Gherkin/Coaster/README.md

## A polar plotter for drawing on paper coasters
