Gherkin/Coaster/PCB/coaster.kicad_pcb

## KiCad design PCB/coaster.kicad_pcb (2022-04-20)

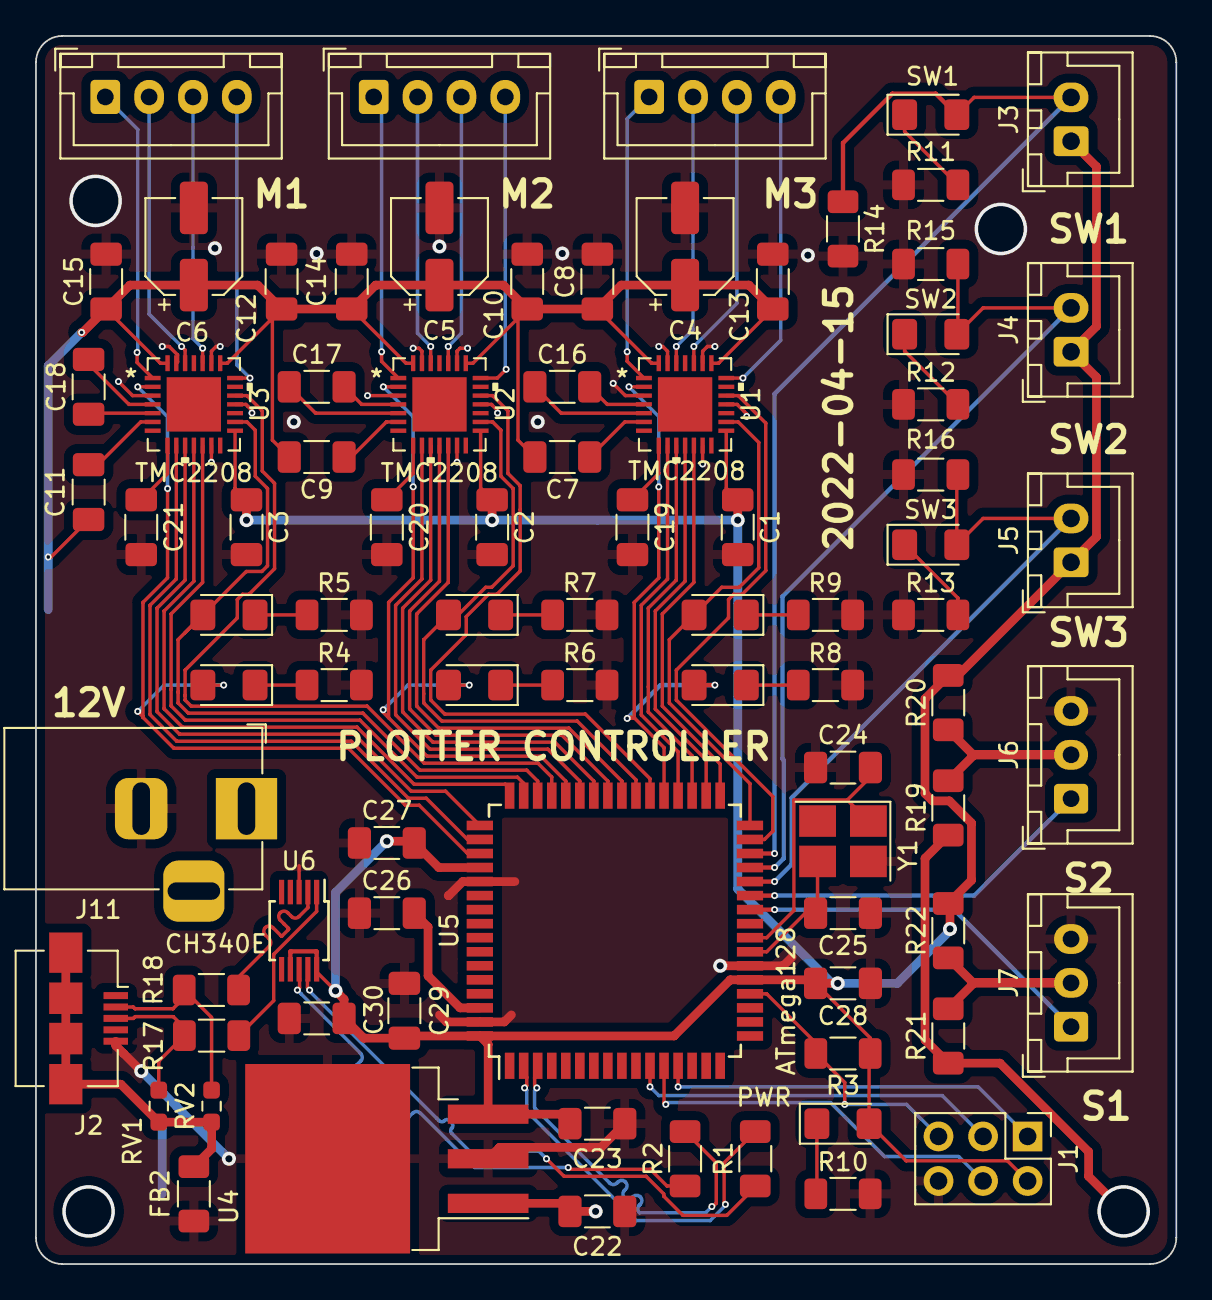
[picture p1: board coaster.kicad_pcb from above]

Board: 2 copper layers, 65.0 x 70.0 mm, 83 parts (0 on the bottom side), 81 nets.

Parts:
C1, C2, C3, C7, C8, C9, C10, C11, C12, C13, C14, C15, C23, C26, C27, C28, C29, C30: 100n; C_1206_3216Metric_Pad1.33x1.80mm_HandSolder
C4, C5, C6: 100u; CP_Elec_5x5.4
C16, C17, C18: 22n; C_1206_3216Metric_Pad1.33x1.80mm_HandSolder
C19, C20, C21: 2.2u; C_1206_3216Metric_Pad1.33x1.80mm_HandSolder
C22: 0.33u; C_1206_3216Metric_Pad1.33x1.80mm_HandSolder
C24, C25: 20p; C_1206_3216Metric_Pad1.33x1.80mm_HandSolder
D1: M1EN; LED_1206_3216Metric_Pad1.42x1.75mm_HandSolder
D2: M1STEP; LED_1206_3216Metric_Pad1.42x1.75mm_HandSolder
D3: M2EN; LED_1206_3216Metric_Pad1.42x1.75mm_HandSolder
D4: M2STEP; LED_1206_3216Metric_Pad1.42x1.75mm_HandSolder
D5: M3EN; LED_1206_3216Metric_Pad1.42x1.75mm_HandSolder
D6: M3STEP; LED_1206_3216Metric_Pad1.42x1.75mm_HandSolder
D7: PWR; LED_1206_3216Metric_Pad1.42x1.75mm_HandSolder
D8: SW1; LED_1206_3216Metric_Pad1.42x1.75mm_HandSolder
D9: SW2; LED_1206_3216Metric_Pad1.42x1.75mm_HandSolder
D10: SW3; LED_1206_3216Metric_Pad1.42x1.75mm_HandSolder
FB2: FerriteBead; R_1206_3216Metric_Pad1.30x1.75mm_HandSolder
J1: AVR-ISP-6; PinHeader_2x03_P2.54mm_Vertical
J2: USB_B_Micro; USB_Micro-B_Amphenol_10104110_Horizontal
J3, J4, J5: Conn_01x02; JST_XH_B2B-XH-A_1x02_P2.50mm_Vertical
J6, J7: Conn_01x03; JST_XH_B3B-XH-A_1x03_P2.50mm_Vertical
J8, J9, J10: Conn_01x04; JST_XH_B4B-XH-A_1x04_P2.50mm_Vertical
J11: Barrel_Jack; BarrelJack_Horizontal
R1, R2: 1k; R_1206_3216Metric_Pad1.30x1.75mm_HandSolder
R3, R14, R15, R16: 10k; R_1206_3216Metric_Pad1.30x1.75mm_HandSolder
R4, R6, R8, R10: 100; R_1206_3216Metric_Pad1.30x1.75mm_HandSolder
R5, R7, R9, R11, R12, R13: 120; R_1206_3216Metric_Pad1.30x1.75mm_HandSolder
R17, R18: 22; R_1206_3216Metric_Pad1.30x1.75mm_HandSolder
R19, R20, R21, R22: 0; R_1206_3216Metric_Pad1.30x1.75mm_HandSolder
RV1, RV2: CG0603MLC-05E; R_0603_1608Metric_Pad0.98x0.95mm_HandSolder
U1, U2, U3: TMC2208; TMC2208-LA
U4: uA7805; TO-263-3_TabPin2
U5: ATmega128; TQFP-64_14x14mm_P0.8mm
U6: CH340E; MSOP-10_3x3mm_P0.5mm
Y1: 16MHz 12pF 60 Ohm +/- 10 ppm; Crystal_SMD_3225-4Pin_3.2x2.5mm_HandSoldering

Connections:
/5V: C1.1, C2.1, C3.1, C23.1, C27.2, C28.2, C29.1, C30.1, D7.2 (A), J1.2 (VCC), J3.1, J4.1, J5.1, R3.1, R20.2, R22.2, U1.15 (VCC_IO), U2.15 (VCC_IO), U3.15 (VCC_IO), U4.3 (OUT), U5.21 (VCC), U5.52 (VCC), U5.64 (AVCC), U6.7 (VCC), U6.10 (V3)
/9V: C4.1, C5.1, C6.1, C7.2, C8.1, C9.2, C10.1, C11.2, C12.1, C13.1, C14.1, C15.1, C22.1, J11.1, R19.1, R21.1, U1.22 (VS), U1.28 (VS), U2.22 (VS), U2.28 (VS), U3.22 (VS), U3.28 (VS), U4.1 (IN)
/AUART_N: R2.2, U5.3 (PE1)
/AUART_P: R1.2, U5.2 (PE0)
/M1AO1: J8.3, U3.24 (OA1)
/M1AO2: J8.4, U3.21 (OA2)
/M1BO1: J8.2, U3.26 (OB1)
/M1BO2: J8.1, U3.1 (OB2)
/M1CPI: C18.1, U3.5 (CPI)
/M1CPO: C18.2, U3.4 (CPO)
/M1DIAG: U3.11 (DIAG), U5.48 (PA3)
/M1DIR: U3.19 (DIR), U5.45 (PA6)
/M1EN: D1.2 (A), U3.2 (ENN), U5.51 (PA0)
/M1INDEX: U3.12 (INDEX), U5.47 (PA4)
/M1MS1: U3.9 (MS1), U5.50 (PA1)
/M1MS2: U3.10 (MS2), U5.49 (PA2)
/M1STEP: D2.2 (A), U3.16 (STEP), U5.46 (PA5)
/M2AO1: J9.3, U2.24 (OA1)
/M2AO2: J9.4, U2.21 (OA2)
/M2BO1: J9.2, U2.26 (OB1)
/M2BO2: J9.1, U2.1 (OB2)
/M2CPI: C17.1, U2.5 (CPI)
/M2CPO: C17.2, U2.4 (CPO)
/M2DIAG: U2.11 (DIAG), U5.41 (PC6)
/M2DIR: U2.19 (DIR), U5.38 (PC3)
/M2EN: D3.2 (A), U2.2 (ENN), U5.44 (PA7)
/M2INDEX: U2.12 (INDEX), U5.40 (PC5)
/M2MS1: U2.9 (MS1), U5.43 (PG2)
/M2MS2: U2.10 (MS2), U5.42 (PC7)
/M2STEP: D4.2 (A), U2.16 (STEP), U5.39 (PC4)
/M3AO1: J10.3, U1.24 (OA1)
/M3AO2: J10.4, U1.21 (OA2)
/M3BO1: J10.2, U1.26 (OB1)
/M3BO2: J10.1, U1.1 (OB2)
/M3CPI: C16.1, U1.5 (CPI)
/M3CPO: C16.2, U1.4 (CPO)
/M3DIAG: U1.11 (DIAG), U5.34 (PG1)
/M3DIR: U1.19 (DIR), U5.31 (PD6)
/M3EN: D5.2 (A), U1.2 (ENN), U5.37 (PC2)
/M3INDEX: U1.12 (INDEX), U5.33 (PG0)
/M3MS1: U1.9 (MS1), U5.36 (PC1)
/M3MS2: U1.10 (MS2), U5.35 (PC0)
/M3STEP: D6.2 (A), U1.16 (STEP), U5.32 (PD7)
/MISO: J1.1 (MISO), U5.13 (PB3)
/MOSI: J1.4 (MOSI), U5.12 (PB2)
/RESET: J1.5 (~RST), R3.2, U5.20 (~RESET)
/S1: J7.1, U5.26 (PD1)
/S2: J6.1, U5.27 (PD2)
/SCK: J1.3 (SCK), U5.11 (PB1)
/SW1: D8.2 (A), J3.2, R14.1, U5.30 (PD5)
/SW2: D9.2 (A), J4.2, R15.1, U5.29 (PD4)
/SW3: D10.2 (A), J5.2, R16.1, U5.28 (PD3)
/UART_N: R2.1, U6.8 (TXD)
/UART_P: R1.1, U6.9 (RXD)
/UD+: R17.2, U6.1 (UD+)
/UD-: R18.2, U6.2 (UD-)
/UUD+: J2.3 (D+), R17.1, RV1.1
/UUD-: J2.2 (D-), R18.1, RV2.1
/shield: FB2.1, J2.6 (Shield), RV1.2, RV2.2
GND: C1.2, C2.2, C3.2, C4.2, C5.2, C6.2, C8.2, C10.2, C12.2, C13.2, C14.2, C15.2, C19.2, C20.2, C21.2, C22.2, C23.2, C24.1, C25.1, C26.1, C27.1, C28.1, C29.2, C30.2, FB2.2, J1.6 (GND), J2.5 (GND), J6.3, J7.3, J11.2, R4.2, R5.2, R6.2, R7.2, R8.2, R9.2, R10.2, R11.1, R12.1, R13.1, R14.2, R15.2, R16.2, U1.3 (GND), U1.13 (CLK), U1.18 (GND), U1.23 (BRA), U1.27 (BRB), U2.3 (GND), U2.13 (CLK), U2.18 (GND), U2.23 (BRA), U2.27 (BRB), U3.3 (GND), U3.13 (CLK), U3.18 (GND), U3.23 (BRA), U3.27 (BRB), U4.2 (GND), U5.22 (GND), U5.53 (GND), U5.63 (GND), U6.3 (GND), Y1.2 (GND), Y1.4 (GND)
unnamed: C7.1, U1.6 (VCP)
unnamed: C9.1, U2.6 (VCP)
unnamed: C11.1, U3.6 (VCP)
unnamed: C19.1, U1.8 (5VOUT)
unnamed: C20.1, U2.8 (5VOUT)
unnamed: C21.1, U3.8 (5VOUT)
unnamed: C24.2, U5.24 (XTAL1), Y1.1 (IN/OUT)
unnamed: C25.2, U5.23 (XTAL2), Y1.3 (OUT/IN)
unnamed: C26.2, U5.62 (AREF)
unnamed: D1.1 (K), R4.1
unnamed: D2.1 (K), R5.1
unnamed: D3.1 (K), R6.1
unnamed: D4.1 (K), R7.1
unnamed: D5.1 (K), R8.1
unnamed: D6.1 (K), R9.1
unnamed: D7.1 (K), R10.1
unnamed: D8.1 (K), R11.2
unnamed: D9.1 (K), R12.2
unnamed: D10.1 (K), R13.2
unnamed: J6.2, R19.2, R20.1
unnamed: J7.2, R21.2, R22.1
