Gherkin/Coaster/(threads)

Thread 1 (2022-05-29):

SPI Serial programming wrong MOSI/MISO

Gherkin, 2022-05-29:
the SPI serial programming header is connected to MOSI/MISO from the SPI hardware bus. actually the UART TX/RX (pin 2, 3) are used for SPI serial programming

Gherkin, 2022-05-29:
fixed in rev2

Closed 2022-05-29.

Thread 2 (2022-05-29):

Cant program using avrdude with serial since no reset line is connected.

Gherkin, 2022-05-29:
usually avrdude pulls DTS to trigger reset on with the arduino bootloader. since i used CH340E we have no DTS, but avrdude seems to pull both RTS and DTS. connect that to reset with cap. See https://forum.arduino.cc/t/does-avrdude-toggle-rts-and-dtr-for-ftdi-reset/635894

Gherkin, 2022-05-29:
fixed in rev2

Closed 2022-05-29.

Thread 3 (2022-05-29):

No sense-resistors for TMC2208

Gherkin, 2022-05-29:
there are no external sense resistors for the stepper motor drivers currently. they can use internal ones, but since the UART config interface isnt connected to the MCU, they cant be set. connect this to be able to use it, maybe also add possiblity for external ones with jumpers or something.
