Gherkin/Coaster/(commit log)

2022-04-19 moved pcb files to pcb dir
    [BOM-coaster.csv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]
2022-04-19 cleaned in pcb
    [BOM-coaster.csv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]
2022-04-20 added some sourcing
    [coaster-CuBottom.gbr, coaster-CuTop.gbr, coaster-EdgeCuts.gbr, coaster-MaskBottom.gbr, coaster-MaskTop.gbr, coaster-NPTH.drl, coaster-PTH.drl, coaster-PasteBottom.gbr]
